sssooofu/sensor-projekt-V2/(commit log)

2026-05-11 Initial scaffold: full sensor hub across all four subprojects
    Hardware: schematic, BOM, PCB guidelines, enclosure docs, KiCad skeleton.
    Firmware: MicroPython drivers (ADS1115, LMP91200, relay), all seven sensors,
    WiFi/protocol/time-sync comms, ring buffer, power manager, relay rules,
    main scheduler loop, dev tooling scripts, calibration unit tests (4/4 pass).
    Server: FastAPI + aiosqlite, all API endpoints live-tested with curl,
    idempotency bug fixed (INSERT OR IGNORE rowcount check).
    Dashboard: vanilla JS SPA with Chart.js charts, device selector, relay controls.
    [V1 pico sensorhub.kicad_pcb, V1 pico sensorhub.kicad_sch, bom.csv, sensor_hub.kicad_pcb, sensor_hub.kicad_sch]
2026-05-11 git: remove accidentally tracked KiCad artifacts, add scope guards
    Untrack ~V1 pico sensorhub.kicad_pcb.lck (covered by *.lck gitignore
    rule but committed before the rule existed) and the .history submodule
    (KiCad local-history folder that got picked up as a nested git repo).
    Add .history/ to .gitignore so it stays out.
    Also commit the scope-guard lines added to all four subproject CLAUDE.md
    files in a previous session.
2026-05-11 hardware: close BOM gaps, flag LMP91200 EOL, name PIR MOSFET
    Add four missing components to bom.csv:
    - U6 BH1750FVI-TR (light sensor, 14wk lead — VEML7700 noted as alternative)
    - Q2 BSS84PXUMA1 (PIR power gate P-ch MOSFET)
    - R17 10kΩ (BSS84 gate pull-up, keeps PIR off during boot)
    - J9 Phoenix 2-pin terminal (PCB-side VSYS+GND input)
    Flag LMP91200SD/NOPB as EOL in both bom.csv and schematic.md —
    part is obsolete and unavailable at Mouser + DigiKey as of May 2026.
    EC section needs alternative before PCB order.
    Expand PIR power gate note in schematic.md with exact circuit
    (BSS84 source/drain/gate, R17 pull-up, GP12 logic).
    [bom.csv]
2026-05-11 hw+fw: swap BH1750 → VEML7700-TT (stock availability)
    BH1750FVI-TR is factory special order with 14-week lead time.
    VEML7700-TT (Vishay, I2C 0x10) is a functional replacement
    and commonly stocked.
    Firmware (sensors/light.py): rewrite driver for VEML7700 register
    interface — gain=1/8x, IT=25ms, 0.9216 lux/count, ~60k lux max.
    Public read(i2c) API unchanged.
    Hardware docs: update bom.csv U6, schematic.md I2C bus + block diagram
    + GP15 (now spare), pcb_guidelines.md rule 10 + zone map.
    firmware/CLAUDE.md GPIO table updated for GP15.
    [bom.csv]
2026-05-11 hardware: mark EC section DNP for v1
    LMP91200 is EOL and unavailable. EC frontend deferred to v2 (AD5933).
    DNP: U3 (LMP91200), R15-R16 (EC RC filter), C3-C5 (EC RC caps +
    LMP91200 VDD decoupling). J8 retained — pins 3-4 (NTC thermistor)
    remain active via ADS1115 AIN1.
    Split C1-C12 BOM row into populated (C1-C2 C6-C12, qty 9) and DNP
    (C3-C5, qty 3) so assembler knows which to skip.
    Total drops from 22.29 to 18.60 CHF (DNP items at 0.00).
    [bom.csv]
2026-05-11 hardware: add KiCad footprint reference, fix U2 package description
    footprints.md maps every BOM line to its KiCad library:footprint path,
    flags three connectors and K1 for datasheet verification, and notes
    the DNP components still need footprints placed (just not populated).
    Also fixes a BOM error: U2 (ADS1115IDGSR) description said "SOIC-16"
    but DGS suffix = VSSOP-10. Wrong footprint if not caught before layout.
    [bom.csv]
2026-05-11 hardware: hide Description/ki_keywords properties in schematic skeleton
    After Update Symbols from Library, KiCad was rendering the full library
    description string (e.g. "Generic connector, single row, 01x03, script
    generated (kicad-library-utils/...)") as visible text on every component,
    causing the connector row to overflow. Pre-setting Description and
    ki_keywords to hidden suppresses this.
    [sensor_hub.kicad_sch]
2026-05-13 firmware: bracket EC ADC read with PWM enable/disable
    PWMs were initialised hot and left running continuously, applying a
    permanent DC offset across the electrodes. Now duty starts at 0;
    ec.read() enables both channels, waits 10 ms for the RC filter to
    settle (τ = 1 ms), samples AIN3, then disables via finally so the
    electrodes are de-energised even on error.
    [ec.py, main.py]
2026-05-13 firmware: rename vbus_mv to vsys_mv in Python code
    ADC3 on Pico W reads VSYS (post-diode supply rail), not the raw 5V
    VBUS. JSON field name kept as "vbus_mv" to preserve the API contract.
2026-05-13 dashboard: add Chart.js date adapter, pin Chart.js version
    Time axis requires a date adapter; without one Chart.js throws at
    runtime and renders nothing. Added chartjs-adapter-date-fns@3.0.0
    (bundle includes date-fns). Also pinned Chart.js to 4.4.3 so a CDN
    update can't silently break the chart.
2026-05-13 dashboard: remove redundant module script tags
    api.js, charts.js, relay.js are already imported by app.js; loading
    them as separate entry points was redundant.
2026-05-13 server: remove bare except around INSERT OR IGNORE
    INSERT OR IGNORE handles duplicates at the SQL level; the try/except
    was only masking real errors (disk full, schema mismatch). Let them
    propagate so FastAPI returns a 500 instead of a silent false positive.
2026-05-13 server: add systemd unit file
    Assumes repo cloned to /home/pi/sensor_projekt_V2 and a venv at
    /home/pi/sensor_projekt_V2/venv. Adjust User/WorkingDirectory/ExecStart
    paths if different. Optional env overrides for DB_PATH, POLL_INTERVAL_S,
    DASHBOARD_DIR are commented in the file.
    Install:
    sudo cp server/sensor_hub.service /etc/systemd/system/
    sudo systemctl daemon-reload
    sudo systemctl enable --now sensor_hub
2026-05-14 hardware: update KiCad project files to v3 format
2026-05-14 firmware: fix vbus_mv reading on Pico W
    GPIO29 (ADC3/VSYS) is shared with the WiFi SPI CS line on Pico W.
    Reading it while WiFi is active returns garbage (~44 mV). Measure
    before wifi.connect() is called.
    [main.py]
2026-05-14 firmware: add boot.py flash window on power-on
    Waits 5 s before main.py starts so mpremote (flash.sh) can connect
    after an unplug/replug. Skips the delay on soft reset (Ctrl-D) to keep
    the mount.sh dev loop instant.
    [boot.py]
